K-4U/Thermostat/README.md

Thermostat
==========

This project will be able to replace a standard Thermostat hanging on your wall. The project is **not** suitable for [OpenTherm](http://en.wikipedia.org/wiki/OpenTherm "OpenTherm").

For now, the project is only an idea.
