K-4U/Thermostat/Docs/bom.xlsx

Waar | Wat | Type | Farnell Nr | Aantal | Prijs P/S | Prijs
Voeding | Step up | NCP1400-5v | 1460673 | 2 | €0.860 | €1.720
Voeding | Elco | 10µF 50V | 9695907 | 2 | €0.300 | €0.600 |  | Totaal | €28.62
Voeding | Elco | 47µF 16V | 1850100 | 2 | €0.270 | €0.540
Voeding | Diode | MBRA140 | 1651133 | 4 | €0.105 | €0.420
Verwarming | Temp sensor | DS1820 | 9724761 | 2 | €5.880 | €0.000 | AL BESTELD
Verwarming | Relais | DS2E-ML2-DC5V | 1448350 | 2 | €4.020 | €8.040
Voeding | Batterij houder | KEYSTONE - 2469 | 1650680 | 1 | €1.450 | €1.450
Voeding | Spoel | 22µH | 2215653 | 2 | €0.070 | €0.140
Display | Trimmer | 10K | 1771725 | 5 | €0.182 | €0.910
Display | FET | IRLML2502PBF | 9102981 | 5 | €0.410 | €2.050
IC | Hoofd | ATMEGA128 |  | 2 |  | €0.000 | AL BESTELD
Voeding | Condensator | 100nF | 1362552 | 10 | €0.027 | €0.270
IC | RTC | ds1307 | 9725253 | 1 | €3.400 | €3.400
IC | Pullups | 10K | 1612522 | 20 | €0.023 | €0.460
IC | Pullups | 33K | 1738979 | 25 | €0.060 | €1.500
Voeding | Batterij houder | CH28-2032LF | 2064725 | 5 | €0.430 | €2.150
 |  |  |  |  |  | €0.000
 |  |  |  |  |  | €0.000
 |  |  |  |  |  | €0.000
 |  |  |  |  |  | €0.000
 |  |  |  |  |  | €0.000
PCB | PCB | PCB |  | 1 | €18.420 | €18.420
