K-4U/Thermostat/Hardware/main_brd.pdf

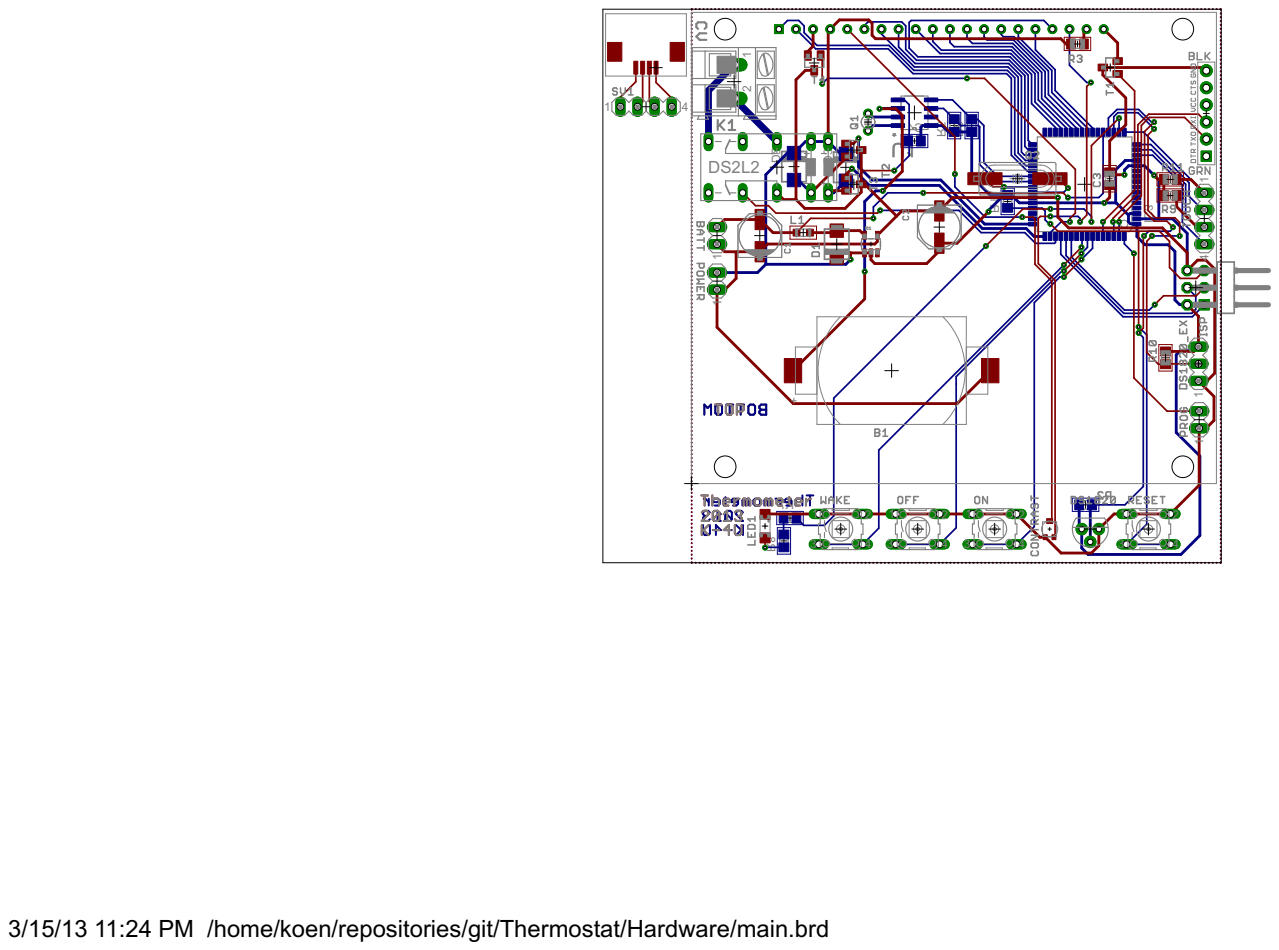
[picture p1: page 1]

3/15/13 11:24 PM /home/koen/repositories/git/Thermostat/Hardware/main.brd
