K-4U/Thermostat/Hardware/main_sch.pdf

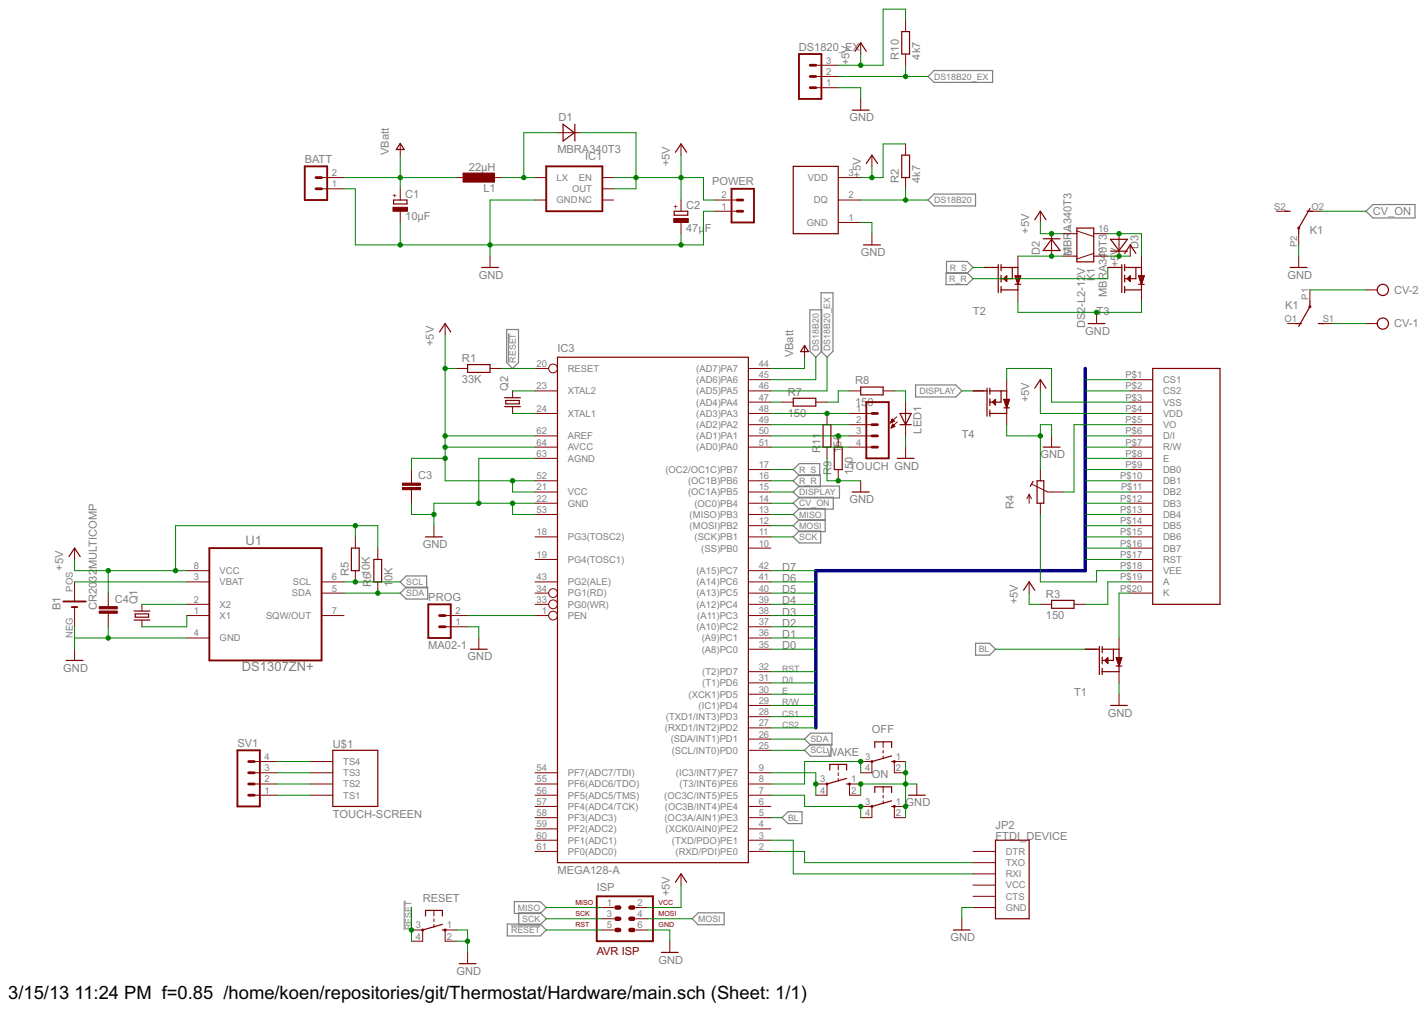
[picture p2: page 1]

49 | 2
50 | 3

3/15/13 11:24 PM f=0.85 /home/koen/repositories/git/Thermostat/Hardware/main.sch (Sheet: 1/1)
