K-4U/Thermostat/Hardware/main.brd

## EAGLE design Hardware/main.brd (2013-03-17)

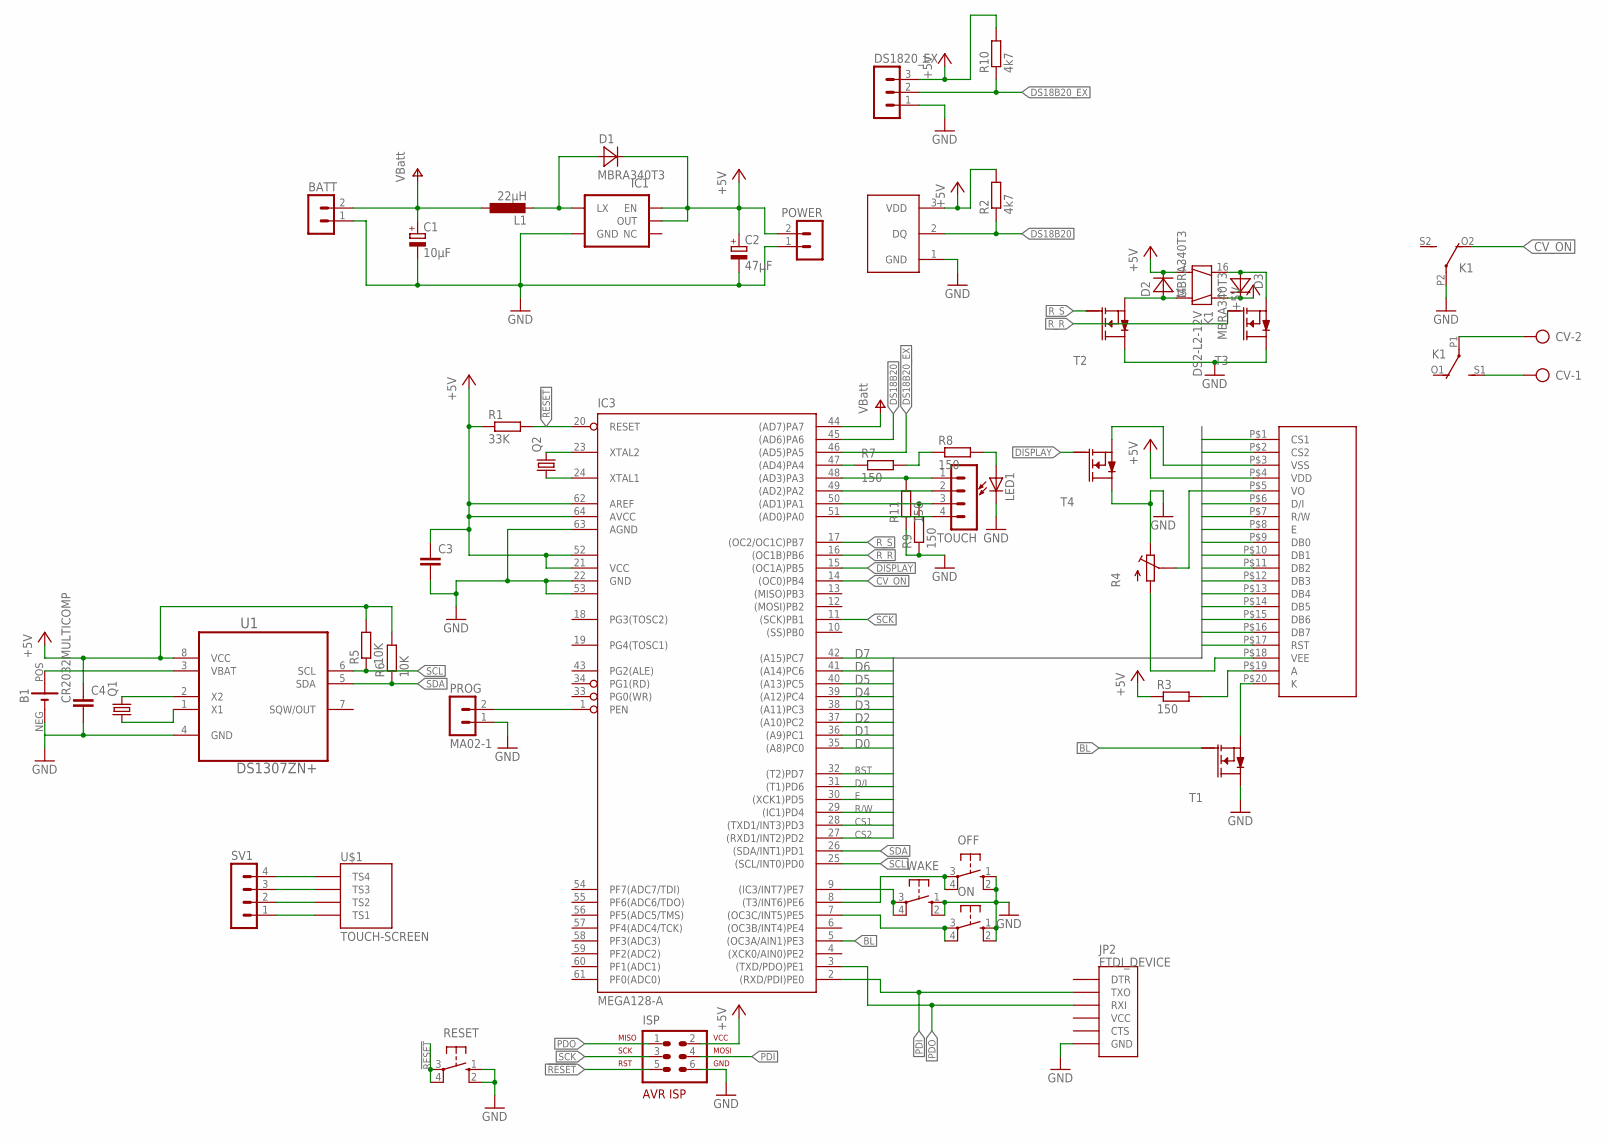
[picture p3: schematic main.sch]

Parts:
B1: CR2032MULTICOMP; CR2032
BATT: MA02-1
C1: 10µF; PANASONIC_D
C2: 47µF; PANASONIC_D
C3, C4: C-EUC0805; C0805
CV: AK300/2
D1, D2, D3: MBRA340T3; SMA
DS1820: DS18B20; TO92
DS1820_EX: MA03-1
IC1: V_REG_NCP1400SOT23-5; SOT23-5
IC3: MEGA128-A; TQFP64
ISP: AVR-ISP-6HORZ; AVR-ISP-6R
JP2: FTDI_DEVICE; FTDI_DEVICE_SIDE
K1: DS2-L2-12V; DS2E-L2
L1: 22µH; L2012C
LED1: LEDSML1206; SML1206
OFF: 10-XX; B3F-10XX
ON: 10-XX; B3F-10XX; MPN B3F-1000
POWER: MA02-1
PROG: MA02-1
Q1: CRYSTALTC26V; TC26V
Q2: CRYSTALSM49; SM49
R1: 33K; R0805
R2, R10: 4k7; R0805
R3, R7, R8, R9, R11: 150; R0805
R4: TRIM
R5, R6: 10K; R0805
RESET: 10-XX; B3F-10XX
SV1: MA04-1
T1, T2, T3, T4: IRLML2502PBF; SOT23
TOUCH: MA04-1
U1: DS1307ZN+; SOIC127P600X175-8N
U$1: TOUCH-SCREEN
U$2: GLCD_LEDSEE
WAKE: 10-XX; B3F-10XX

Connections:
!RESET: IC3.20 (RESET), ISP.5, R1.2, RESET.3, RESET.4 (P1)
+5V: C2.+, C3.1, C4.1, D1.C, D2.C, D3.C, DS1820.3 (VDD), DS1820_EX.3, IC1.1 (EN), IC1.2 (OUT), IC3.21 (VCC), IC3.52 (VCC1), IC3.62 (AREF), IC3.64 (AVCC), ISP.2, K1.1 (2), K1.2 (3), POWER.2 (4), R1.1, R2.2, R3.1, R5.2, R6.2, R10.2, U1.8 (VCC), U$2.P$4 (VDD)
BL: IC3.5 ((OC3A/AIN1)PE3), T1.1 (G)
CS1: IC3.28 ((TXD1/INT3)PD3), U$2.P$1 (CS1)
CS2: IC3.27 ((RXD1/INT2)PD2), U$2.P$2 (CS2)
CV_ON: IC3.14 ((OC0)PB4), K1.O2 (O)
D0: IC3.35 ((A8)PC0), U$2.P$9 (DB0)
D1: IC3.36 ((A9)PC1), U$2.P$10 (DB1)
D2: IC3.37 ((A10)PC2), U$2.P$11 (DB2)
D3: IC3.38 ((A11)PC3), U$2.P$12 (DB3)
D4: IC3.39 ((A12)PC4), U$2.P$13 (DB4)
D5: IC3.40 ((A13)PC5), U$2.P$14 (DB5)
D6: IC3.41 ((A14)PC6), U$2.P$15 (DB6)
D7: IC3.42 ((A15)PC7), U$2.P$16 (DB7)
D/I: IC3.31 ((T1)PD6), U$2.P$6 (D/I)
DISPLAY: IC3.15 ((OC1A)PB5), T4.1 (G)
DS18B20: DS1820.2 (DQ), IC3.45 ((AD6)PA6), R2.1
DS18B20_EX: DS1820_EX.2, IC3.46 ((AD5)PA5), R10.1
E: IC3.30 ((XCK1)PD5), U$2.P$8 (E)
GND: B1.NEG (-), BATT.1 (3), C1.-, C2.-, C3.2, C4.2, DS1820.1 (GND), DS1820_EX.1, IC1.4 (GND), IC3.22 (GND), IC3.53 (GND1), IC3.63 (AGND), ISP.6, JP2.P$6 (GND), K1.P2, LED1.C, OFF.1 (S), OFF.2 (S1), ON.1 (S), ON.2 (S1), POWER.1 (3), PROG.1 (3), R4.1, R9.1, R11.1, RESET.1 (S), RESET.2 (S1), T1.3 (D), T2.3 (D), T3.3 (D), T4.3 (D), U1.4 (GND), WAKE.1 (S), WAKE.2 (S1)
unnamed: D1.A, IC1.5 (LX), L1.2
unnamed: SV1.4, U$1.P$1 (TS4)
unnamed: SV1.3, U$1.P$2 (TS3)
unnamed: SV1.2, U$1.P$3 (TS2)
unnamed: SV1.1, U$1.P$4 (TS1)
unnamed: R3.2, U$2.P$19 (A)
unnamed: IC3.1 (PEN), PROG.2 (4)
unnamed: T1.2 (S), U$2.P$20 (K)
unnamed: IC3.9 ((IC3/INT7)PE7), WAKE.3, WAKE.4 (P1)
unnamed: R4.3, U$2.P$18 (VEE)
unnamed: R4.2 (T), U$2.P$5 (VO)
unnamed: D2.A, K1.15 (4), T2.2 (S)
unnamed: D3.A, K1.16 (1), T3.2 (S)
unnamed: IC3.8 ((T3/INT6)PE6), OFF.3, OFF.4 (P1)
unnamed: CV.2, K1.P1
unnamed: CV.1, K1.S1 (S)
unnamed: IC3.51 ((AD0)PA0), TOUCH.4
unnamed: IC3.50 ((AD1)PA1), R9.2, TOUCH.3
unnamed: IC3.49 ((AD2)PA2), TOUCH.2
unnamed: IC3.48 ((AD3)PA3), R11.2, TOUCH.1
unnamed: T4.2 (S), U$2.P$3 (VSS)
unnamed: B1.POS (+), U1.3 (VBAT)
unnamed: Q1.1, U1.1 (X1)
unnamed: Q1.2, U1.2 (X2)
unnamed: IC3.7 ((OC3C/INT5)PE5), ON.3, ON.4 (P1)
unnamed: LED1.A, R8.2
unnamed: IC3.47 ((AD4)PA4), R7.1
unnamed: R7.2, R8.1
unnamed: IC3.23 (XTAL2), Q2.2
unnamed: IC3.24 (XTAL1), Q2.1
PDI: IC3.2 ((RXD/PDI)PE0), ISP.4, JP2.P$2 (TXO)
PDO: IC3.3 ((TXD/PDO)PE1), ISP.1, JP2.P$3 (RXI)
R/W: IC3.29 ((IC1)PD4), U$2.P$7 (R/W)
RST: IC3.32 ((T2)PD7), U$2.P$17 (RST)
R_R: IC3.16 ((OC1B)PB6), T3.1 (G)
R_S: IC3.17 ((OC2/OC1C)PB7), T2.1 (G)
SCK: IC3.11 ((SCK)PB1), ISP.3
SCL: IC3.25 ((SCL/INT0)PD0), R5.1, U1.6 (SCL)
SDA: IC3.26 ((SDA/INT1)PD1), R6.1, U1.5 (SDA)
V+: BATT.2 (4), C1.+, IC3.44 ((AD7)PA7), L1.1

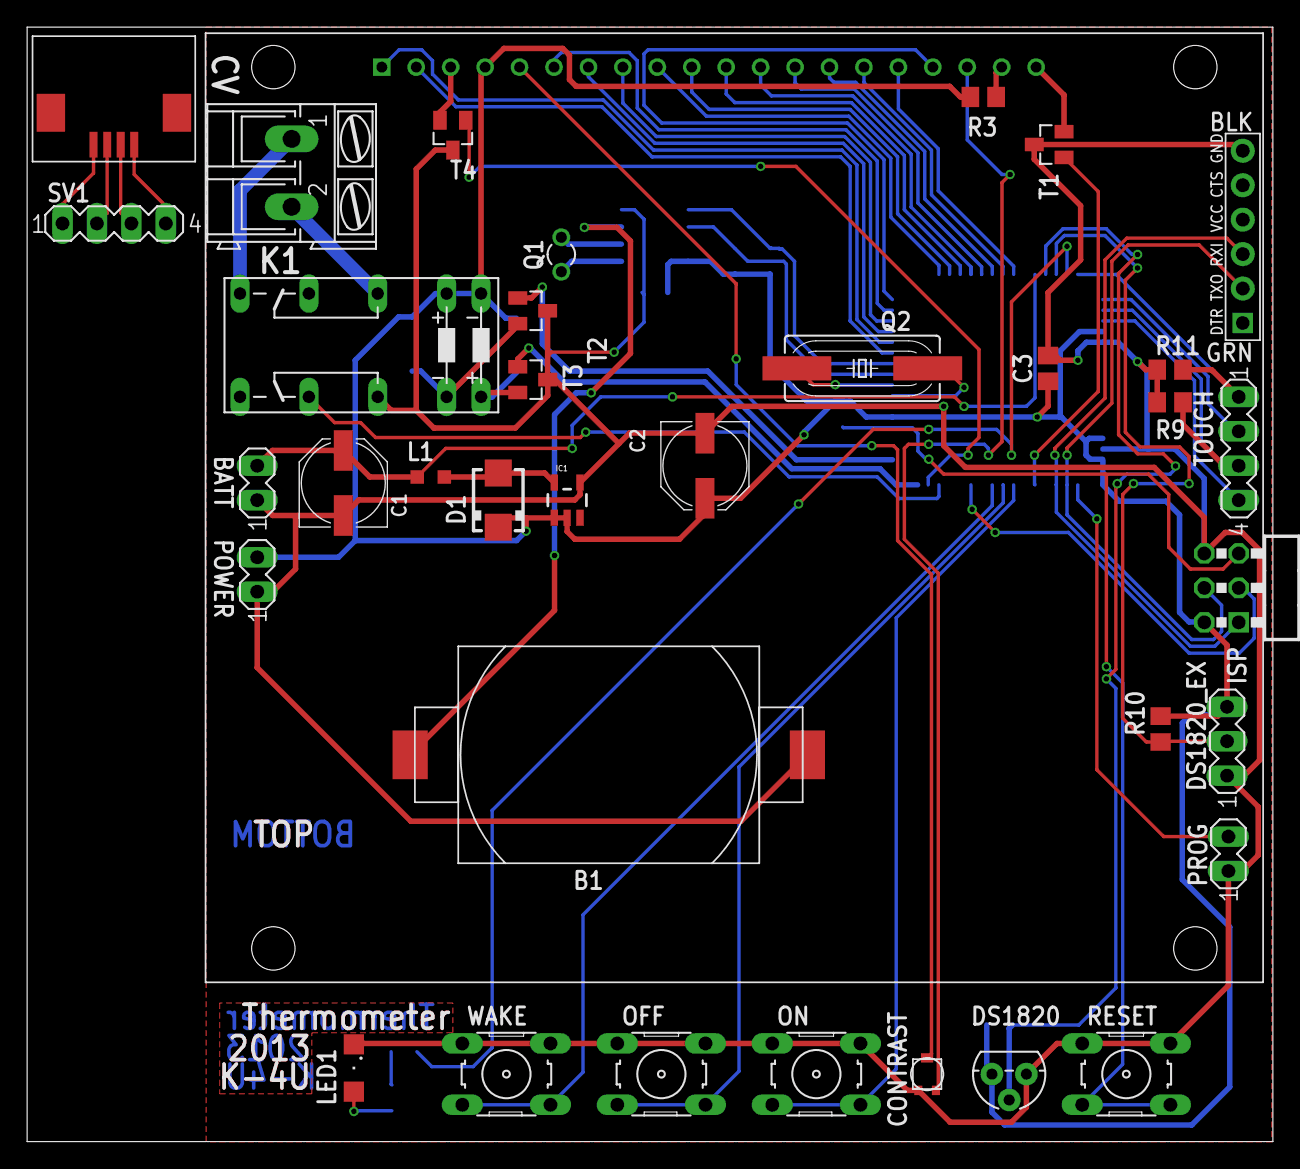
[picture p4: board main.brd from above]

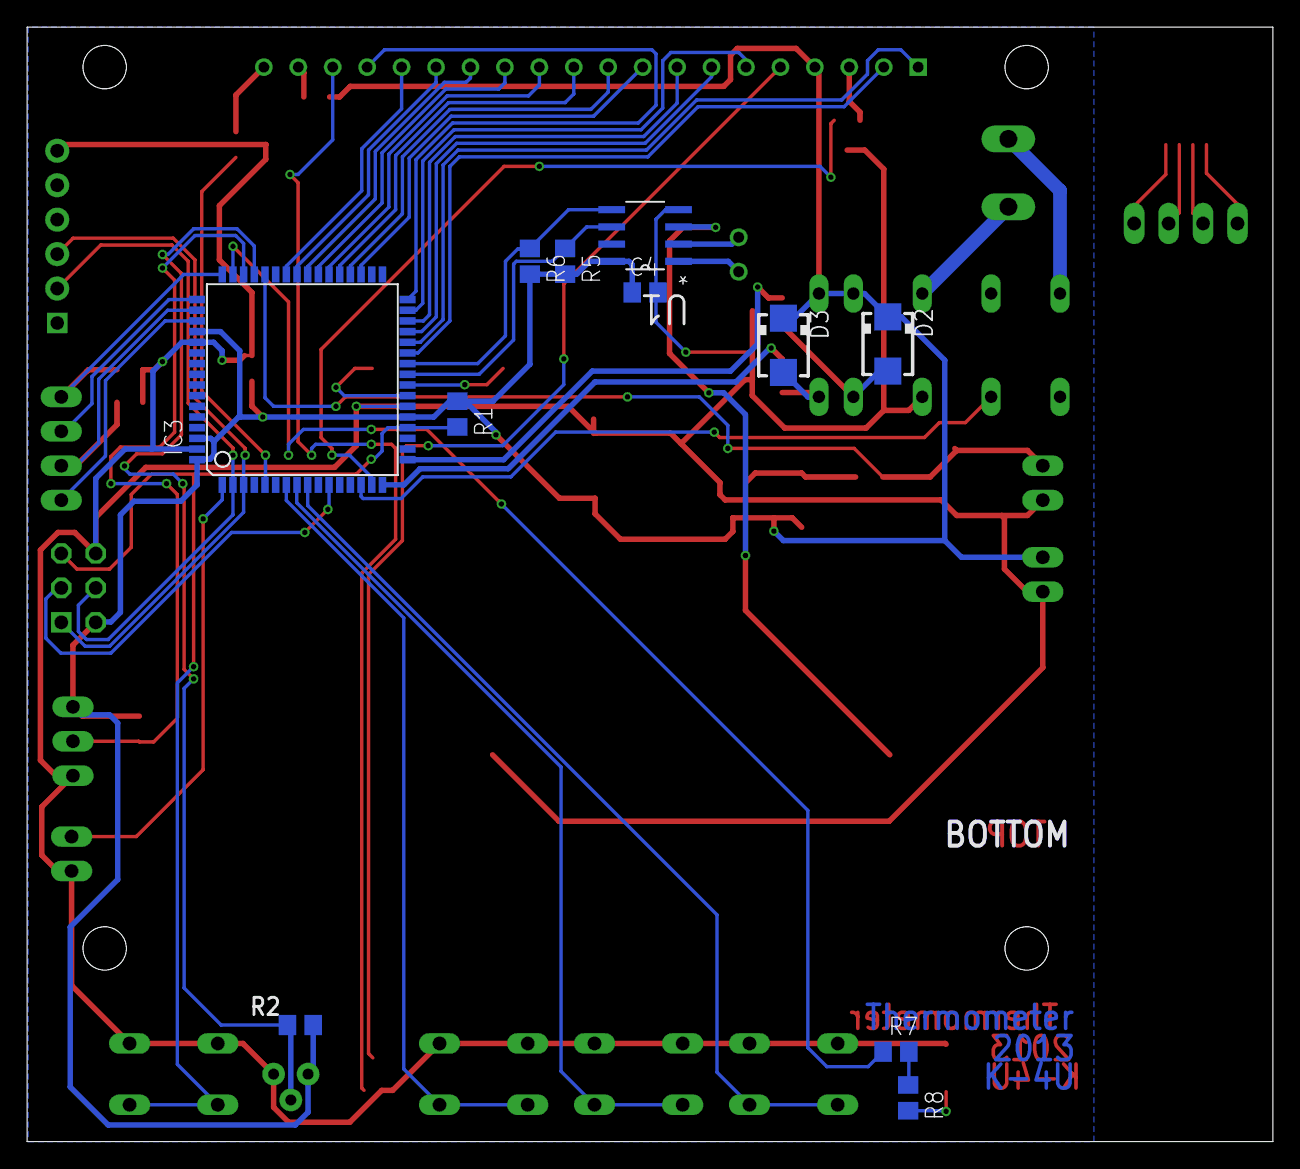
[picture p5: board main.brd from below]

Board: 2 copper layers, 91.9 x 82.2 mm, 47 parts (11 on the bottom side), 60 nets.
