K-4U/Thermostat/Firmware/Thermostaat_new/ds1307.c

/*
 * ds1307.c
 *
 * Created: 8-2-2013 15:19:19
 *  Author: Koen Beckers
 */ 

#include <util/twi.h>
#include "Headers/config.h"
#include "Headers/ds1307.h"

#define MAX_TRIES	50

#define DS1307_ID    0xD0        // I2C DS1307 Device Identifier
#define DS1307_ADDR  0x00        // I2C DS1307 Device Address

#define I2C_START 0
#define I2C_DATA 1
#define I2C_DATA_ACK 2
#define I2C_STOP 3
#define ACK 1
#define NACK 0

// DS1307 Register Address
// Second: ds1307_addr[0]
// Minute: ds1307_addr[1]
// Hour  : ds1307_addr[2]
// Day   : ds1307_addr[3]
// Date  : ds1307_addr[4]
// Month : ds1307_addr[5]
// Year  : ds1307_addr[6]

#define HOUR_24 0
#define HOUR_12 1

char sdigit[3]={'0','0','\0'};
char hour_mode, ampm_mode;

void init_ds1307(void){
	// Initial TWI/I2C Peripheral
	TWSR = 0x00;   // Select Prescaler of 1
	// SCL frequency = 11059200 / (16 + 2 * 48 * 1) = 98.743 khz
	TWBR = 0x30;   // 48 Decimal
	
	DDRC |= _BV(PC7) | _BV(PC6);
	PORTC &= ~(_BV(PC7) | _BV(PC6));
}

uint8_t maxDays(const structDate *toRead){
	uint8_t month = toRead->month;
	if(month == 2){
		return 28;
	}else if(month <= 7 && (month % 2)){
		return 31;
	}else if(month >= 8 && ((month % 2) == 0)){
		return 31;
	}else{
		return 30;			
	}
}

void getDayOfWeek(structDate *toRead){
	uint8_t month = toRead->month;
	uint8_t year = toRead->year;
	uint8_t day = toRead->date;
	if (month < 3){
		month = month + 12;
		year = year - 1;
	}
	toRead->day = (
		day
		+ (2 * month)
		+ (int) (6 * (month + 1) / 10)
		+ year
		+ (int) (year / 4)
		- (int) (year / 100)
		+ (int) (year / 400)
		+ 1
	) % 7;
}


/* START I2C Routine */
unsigned char i2c_transmit(const unsigned char type) {
	switch(type) {
		case I2C_START:    // Send Start Condition
			TWCR = (1 << TWINT) | (1 << TWSTA) | (1 << TWEN);
			break;
		case I2C_DATA:     // Send Data with No-Acknowledge
			TWCR = (1 << TWINT) | (1 << TWEN);
			break;
		case I2C_DATA_ACK: // Send Data with Acknowledge
			TWCR = (1 << TWEA) | (1 << TWINT) | (1 << TWEN);
			break;
		case I2C_STOP:     // Send Stop Condition
			TWCR = (1 << TWINT) | (1 << TWEN) | (1 << TWSTO);
			return 0;
	}

	// Wait for TWINT flag set on Register TWCR
	while (!(TWCR & (1 << TWINT)));

	// Return TWI Status Register, mask the prescaller bits (TWPS1,TWPS0)
	return (TWSR & 0xF8);
	}

char i2c_start(const unsigned int dev_id, const unsigned int dev_addr, const unsigned char rw_type){
	unsigned char n = 0;
	unsigned char twi_status;
	char r_val = -1;

	i2c_retry:
	if (n++ >= MAX_TRIES) return r_val;

	// Transmit Start Condition
	twi_status=i2c_transmit(I2C_START);

	// Check the TWI Status
	if (twi_status == TW_MT_ARB_LOST) goto i2c_retry;
	if ((twi_status != TW_START) && (twi_status != TW_REP_START)) goto i2c_quit;

	// Send slave address (SLA_W)
	TWDR = (dev_id & 0xF0) | (dev_addr & 0x07) | rw_type;

	// Transmit I2C Data
	twi_status=i2c_transmit(I2C_DATA);

	// Check the TWSR status
	if ((twi_status == TW_MT_SLA_NACK) || (twi_status == TW_MT_ARB_LOST)) goto i2c_retry;
	if (twi_status != TW_MT_SLA_ACK) goto i2c_quit;

	r_val=0;

	i2c_quit:
	return r_val;
}

void i2c_stop(void){
	unsigned char twi_status;

	// Transmit I2C Data
	twi_status=i2c_transmit(I2C_STOP);
}

char i2c_write(const char data){
	unsigned char twi_status;
	char r_val = -1;

	// Send the Data to I2C Bus
	TWDR = data;

	// Transmit I2C Data
	twi_status=i2c_transmit(I2C_DATA);

	// Check the TWSR status
	if (twi_status != TW_MT_DATA_ACK) goto i2c_quit;

	r_val=0;

	i2c_quit:
	return r_val;
}

char i2c_read(char *data, const char ack_type){
	unsigned char twi_status;
	char r_val = -1;               

	printf("i2c_read\r\n");
	if (ack_type) {
	// Read I2C Data and Send Acknowledge
		printf("acking\r\n");
		twi_status=i2c_transmit(I2C_DATA_ACK);
		
		printf("I2c status: %i\r\n",twi_status);
		if (twi_status != TW_MR_DATA_ACK) goto i2c_quit;
	} else {
	// Read I2C Data and Send No Acknowledge
		twi_status=i2c_transmit(I2C_DATA);

		if (twi_status != TW_MR_DATA_NACK) goto i2c_quit;
	}

	// Get the Data
	*data=TWDR;
	r_val=0;

	i2c_quit:
	return r_val;
}

// Convert Decimal to Binary Coded Decimal (BCD)
char dec2bcd(const char num){
	return ((num/10 * 16) + (num % 10));
}

// Convert Binary Coded Decimal (BCD) to Decimal
char bcd2dec(const char num){
	return ((num/16 * 10) + (num % 16));
}

void Read_DS1307(dateTime *toRead){
	char data;
	// First we initial the pointer register to address 0x00
	// Start the I2C Write Transmission
	//printf("Starting i²C\r\n");
	i2c_start(DS1307_ID,DS1307_ADDR,TW_WRITE);

	// Start from Address 0x00
	//printf("Writing 0 as address\r\n");
	i2c_write(0x00);

	//printf("Stopping the write\r\n");
	// Stop I2C Transmission
	i2c_stop();

	// Start the I2C Read Transmission
	//printf("Starting the read\r\n");
	i2c_start(DS1307_ID,DS1307_ADDR,TW_READ);

	// Read the Second Register, Send Master Acknowledge
	//printf("Reading seconds\r\n");
	i2c_read(&data,ACK);
	toRead->time.seconds=bcd2dec(data & 0x7F);
	printf("Seconds: %i\r\n",bcd2dec(data * 0x7F));

	// Read the Minute Register, Send Master Acknowledge
	//printf("Reading minutes\r\n");
	i2c_read(&data,ACK);
	toRead->time.minute = bcd2dec(data);
	printf("Minutes: %i\r\n",bcd2dec(data));

	// Read the Hour Register, Send Master Acknowledge
	//printf("Reading hours\r\n");
	i2c_read(&data,ACK);
	if ((data & 0x40) == 0x40) {
		hour_mode = HOUR_12;
		ampm_mode=(data & 0x20) >> 5;   // ampm_mode: 0-AM, 1-PM
		toRead->time.hours = bcd2dec(data & 0x1F);
	} else {
		hour_mode = HOUR_24;
		ampm_mode=0;
		toRead->time.hours = bcd2dec(data & 0x3F);
	}

	// Read the Day of Week Register, Send Master Acknowledge
	//printf("Reading Day of week\r\n");
	i2c_read(&data,ACK);
	toRead->date.day = bcd2dec(data);

	// Read the Day of Month Register, Send Master Acknowledge
	i2c_read(&data,ACK);
	toRead->date.date = bcd2dec(data);

	// Read the Month Register, Send Master Acknowledge
	i2c_read(&data,ACK);
	toRead->date.month = bcd2dec(data);

	// Read the Year Register, Send Master No Acknowledge
	i2c_read(&data,NACK);
	toRead->date.year = bcd2dec(data);
	// Stop I2C Transmission
	i2c_stop();
}

void Write_DS1307(const dateTime *toWrite){
	unsigned char i, hour_format;
	uint8_t ds1307_addr[7];
	ds1307_addr[0] = toWrite->time.seconds;
	ds1307_addr[1] = toWrite->time.minute;
	ds1307_addr[2] = toWrite->time.hours;
	ds1307_addr[3] = toWrite->date.day;
	ds1307_addr[4] = toWrite->date.date;
	ds1307_addr[5] = toWrite->date.month;
	ds1307_addr[6] = toWrite->date.year;
	
	currentDateTime = *toWrite;

	// Make sure we enable the Oscillator control bit CH=0 on Register 0x00
	ds1307_addr[0]=ds1307_addr[0] & 0x7F;

	// Start the I2C Write Transmission
	i2c_start(DS1307_ID,DS1307_ADDR,TW_WRITE);

	// Start from Address 0x00
	i2c_write(0x00);

	// Write the data to the DS1307 address start at 0x00
	// DS1307 automatically will increase the Address.
	for (i=0; i<7; i++) {
		if (i == 2) {
			hour_format=dec2bcd(ds1307_addr[i]);

			if (hour_mode) {
				hour_format |= (1 << 6);
				if (ampm_mode)
					hour_format |= (1 << 5);
				else
					hour_format &= ~(1 << 5);
			} else {
				hour_format &= ~(1 << 6);
			}

			i2c_write(hour_format);
		} else {
			i2c_write(dec2bcd(ds1307_addr[i]));
		}
	}

	// Stop I2C Transmission
	i2c_stop();
}

// Implementing integer value from 00 to 99
char *num2str(char number){
	unsigned char digit;     

	digit = '0';                       // Start with ASCII '0'
	while(number >= 10)                // Keep Looping for larger than 10
	{
		digit++;                         // Increase ASCII character
		number -= 10;                    // Subtract number with 10
	}

	sdigit[0]='0';                     // Default first Digit to '0'
	if (digit != '0')
		sdigit[0]=digit;                 // Put the Second digit

	sdigit[1]='0' + number;
	return sdigit;
}
