K-4U/Thermostat/Firmware/Thermostaat_new/Headers/bitmaps.h

/*
 * bitmaps.h
 *
 * Created: 7-2-2013 15:30:32
 *  Author: Koen Beckers
 */ 


#ifndef BITMAPS_H_
#define BITMAPS_H_
#include "bitmaps/batteryIndicator.h"
#include "bitmaps/bootscreen.h"
#include "bitmaps/flame.h"
#include "bitmaps/moon.h"
#include "bitmaps/sun.h"
#include "bitmaps/externalTemp.h"
#include "bitmaps/internalTemp.h"



#endif /* BITMAPS_H_ */
