K-4U/Thermostat/Firmware/Thermostaat_new/Headers/ds1820.h

/*
 * ds1820_extern.h
 *
 * Created: 7-2-2013 15:30:32
 *  Author: Koen Beckers
 */ 
#ifndef DS1820_EXTERN_H_
#define DS1820_EXTERN_H_

void init_ds1820(void);

void ds1820_extern_read(void);
void ds1820_intern_read(void);


#endif /* DS1820_EXTERN_H_ */
