K-4U/Thermostat/Firmware/Thermostaat_new/Headers/timer.h

/*
 * timer.h
 *
 * Created: 7-2-2013 16:56:18
 *  Author: Koen Beckers
 */ 


#ifndef TIMER_H_
#define TIMER_H_

extern void init_pwm();
extern void init_timer1(void);
extern void timer(void);


#endif /* TIMER_H_ */
