K-4U/Thermostat/(commit log)

2013-01-30 Added schematic, PCB and BOM
    [bom.xlsx, main.brd, main.sch]
2013-01-30 Added a ds1307
    [bom.xlsx, main.brd, main.sch]
2013-01-31 Rotated the PCB, Added a button + LED
    [main.brd, main.sch]
2013-02-02 Partially working firmware. It's just a test
    [main.brd, main.sch]
2013-02-03 Presets added, time added, CV added
    [main.brd]
2013-02-10 Added some extra components + bigger PCB
    [main.brd, main.sch]
2013-02-10 Code in a new style
    [bom.xlsx]
2013-02-13 This pcb version has been send to seeed.
    [main.GBL, main.GBO, main.GBP, main.GBS, main.GTL, main.GTO, main.GTP, main.GTS]
2013-03-17 New programming header
    [main.brd, main.sch]
